mattvenn/tt07-mos-bandgap/(commit log)

2024-05-25 mosfet mult param and add a load
    [bandgap.sch]
2024-05-25 added opamp buffer
    [bandgap.sch]
2024-05-25 opamp schem and sym
    [p3_opamp.sch]
2024-05-26 clean top level drc and lvs
    [bandgap.sch]
2024-05-29 wip design exploration
    [bandgap-op.sch, tb_bandgap.sch]
2024-05-29 sweep r values
    [bandgap-op.sch]
2024-05-30 just iterated over bottom middle width to find a good value
    [bandgap-op.sch]
2024-05-30 finished playing
    [bandgap-op.sch]
2024-05-30 finalised values, about to re-layout bandgap;
    [bandgap-op.sch, bandgap.sch, tb_bandgap.sch]
2024-05-30 new bandgap layout
    [bandgap.sch, tb_bandgap.sch]
2024-05-31 try tie pmos body to gnd
    [bandgap-op-dtmos.sch]
2024-05-31 add dtmos version
    [bandgap_dtmos.sch, tb_bandgap.sch]
2024-05-31 add dtmos variant
    [tb_bandgap.sch]
2024-05-31 fix missing wire
